n1co44/Poolmaster/Nextion/2 - Clavier.png

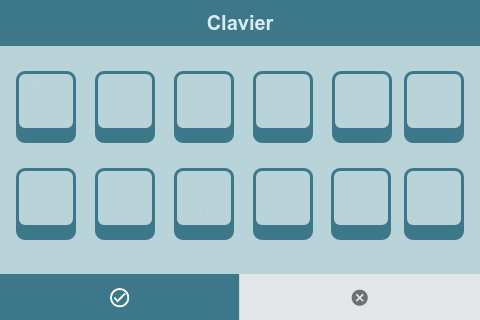
Nextion/2 - Clavier.png
