n1co44/Poolmaster/Nextion/3 - PAC.png

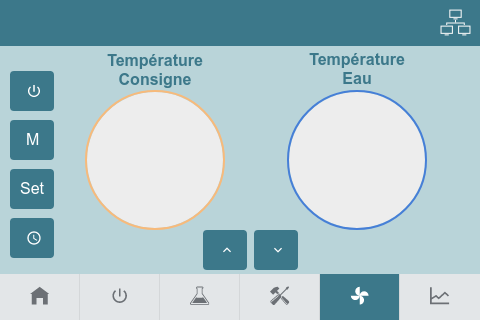
Nextion/3 - PAC.png
