n1co44/Poolmaster/Nextion/6 - Home.png

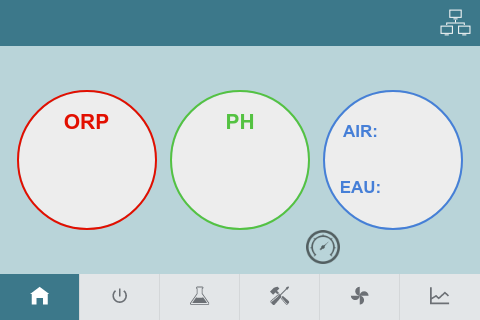
Nextion/6 - Home.png
