n1co44/Poolmaster/Nextion/7 - ParamÃtre.png

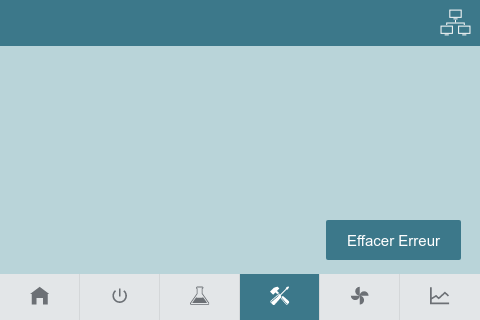
Nextion/7 - ParamÃtre.png
