n1co44/Poolmaster/Nextion/9 - Relais.png

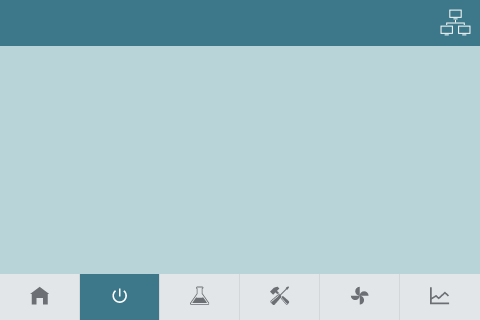
Nextion/9 - Relais.png
