n1co44/Poolmaster/Nextion/11 - Mesures.png

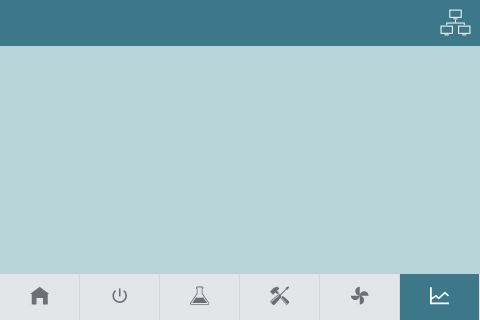
Nextion/11 - Mesures.png
