n1co44/Poolmaster/Nextion/Page2.png

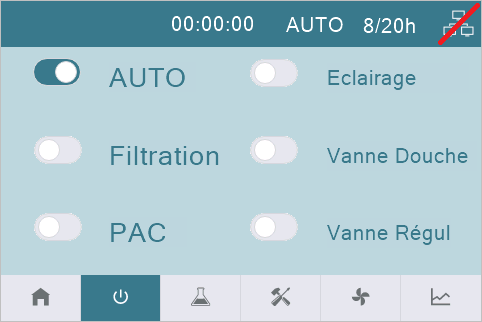
Nextion/Page2.png
