n1co44/Poolmaster/Nextion/Page4.png

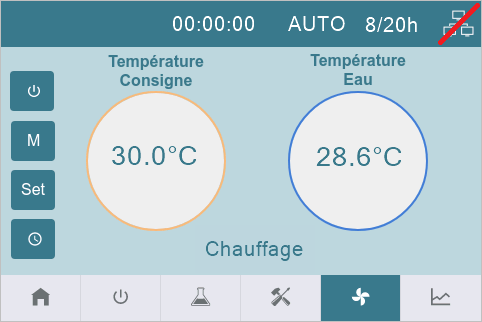
Nextion/Page4.png
