n1co44/Poolmaster/Nextion/PageCalib.png

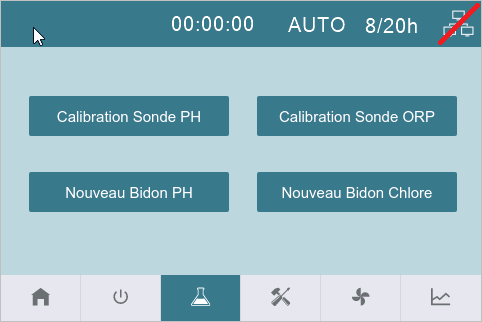
Nextion/PageCalib.png
