n1co44/Poolmaster/Nextion/5 - Page Calibration.png

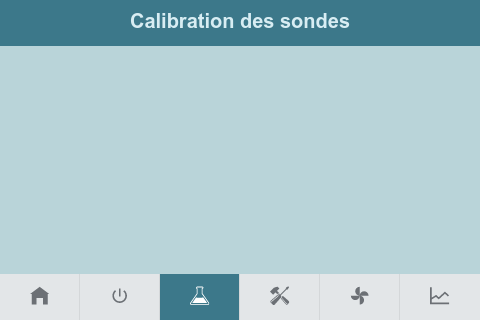
Nextion/5 - Page Calibration.png
