n1co44/Poolmaster/Nextion/10 - Calibration.png

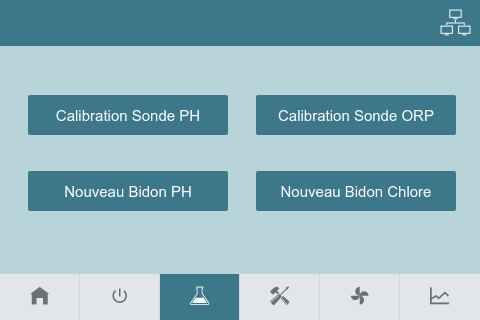
Nextion/10 - Calibration.png
