n1co44/Poolmaster/Nextion/PageCalibrationBidon.png

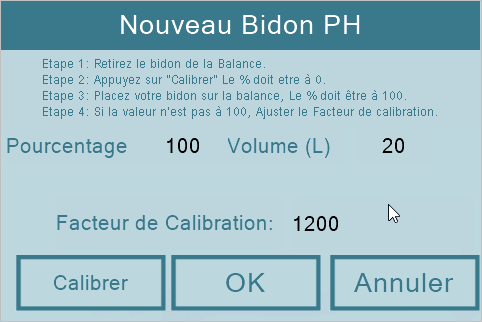
Nextion/PageCalibrationBidon.png
